lexbailey/C88/(commit log)

2015-03-13 YAY! all three tests work. Still need to implement the test and skip instructions and the IO things
    [DataPath.vhd, test_program_1.vhd, test_program_2.vhd, test_program_3.vhd]
2015-03-16 Added test instruction handling, still a bug to chase. Timing is off, may need to clock the comparator output into a flipflop
    [Control.vhd, DataPath.vhd, InstructionDecoder.vhd, PC.vhd, comparator.vhd, test_program_2.vhd, test_program_3.vhd, test_program_4.vhd]
2015-03-17 added simple assembler program
2015-03-27 assembly stuff
2015-03-28 removed PC skip input, not needed. Modified test.
    [Control.vhd, DataPath.vhd, PC.vhd, test_program_4.vhd]
2015-04-19 assemble.pl: made instructions case insesitive. Made error messages tidyer by stopping perl getting involved, alowed hex numbers as raw numbers in programs
2015-05-05 added missing test program
    [test_program_6_jma.vhd]
2015-06-02 fixed bug in JMA instructions, lucky that instruction is almost never used
    [Control.vhd]
2015-06-03 Got view selector working, started on clock selector, fixed reset debouncer issue.
    [C88.vhd, Control.vhd, DataPath.vhd]
2015-06-03 Fix step pulse bug, attempted to get clock selection working but still can't fathom it
    [C88.vhd, Control.vhd, DataPath.vhd]
2015-06-04 Made simulations work better, added top level tb and found the main cause of the speed selector bug.
    [C88.vhd, Control.vhd, Debouncer.vhd, matrix_driver.vhd, spi_master.vhd]
2015-06-10 Fixed bug in shift and rotate (aded missing bus from decoder to ALU) also fixed GP Input bug, decoder wasn't selecting correct input
    [ALU.vhd, C88.vhd, Control.vhd, DataPath.vhd, InstructionDecoder.vhd]
2015-06-20 fixed pin layout in documentation
